TianBingzhuo/smart-car-embedded-vision-system/firmware/openart/README.zh-CN.txt

OpenART 部署说明：

把对应的脚本文件放到对应 SD 卡里，文件名改成 main.py 就会自动运行。down 对应下位板，up 对应上位板。
注意：目标检测的 SD 卡做了标记，识别的 SD 卡没做标记。两张卡里的模型不一样，不能混着放。

串口命令说明：
发 0：全部待机
发 1：上位 art 开启识别卡片
发 2：上位 art 开启识别字母
发 3：上位 art 开启识别数字 1、2、3
发 4：下位 art 开启目标检测

切换功能时先发 0，再发目标命令（1/2/3/4）。
