TianBingzhuo/smart-car-embedded-vision-system/firmware/rt1064/project/code/README.txt

如果你要加自己的代码文件，直接放到 CODE 文件夹下就行，不用再建子文件夹。然后在工程里添加文件就可以编译了。
