TianBingzhuo/smart-car-embedded-vision-system/hardware/pcb/PCB_钛合金狗眼_2026-05-22.png

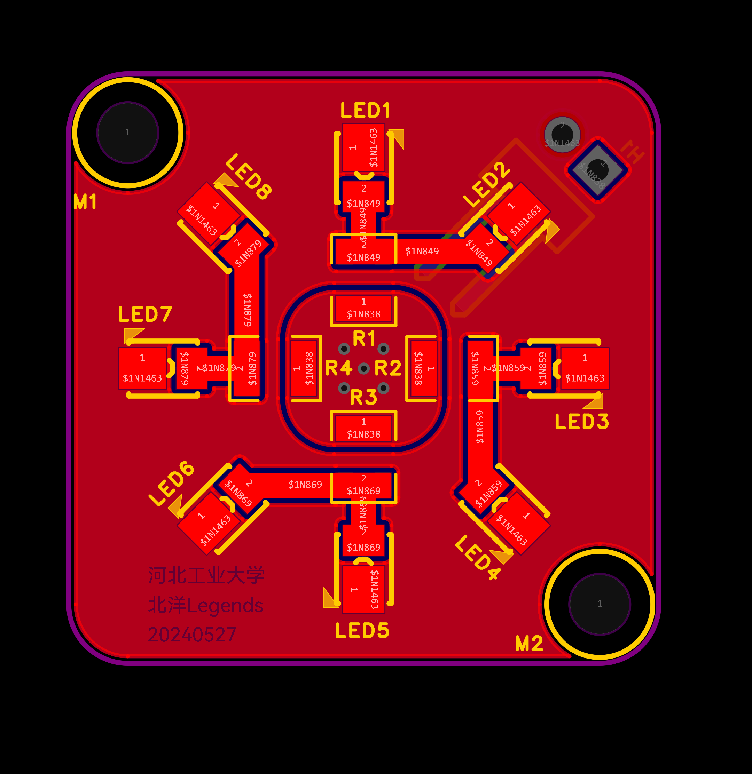
hardware/pcb/PCB_钛合金狗眼_2026-05-22.png
