TianBingzhuo/smart-car-embedded-vision-system/hardware/pcb/PCB_驱动板_2026-05-22.png

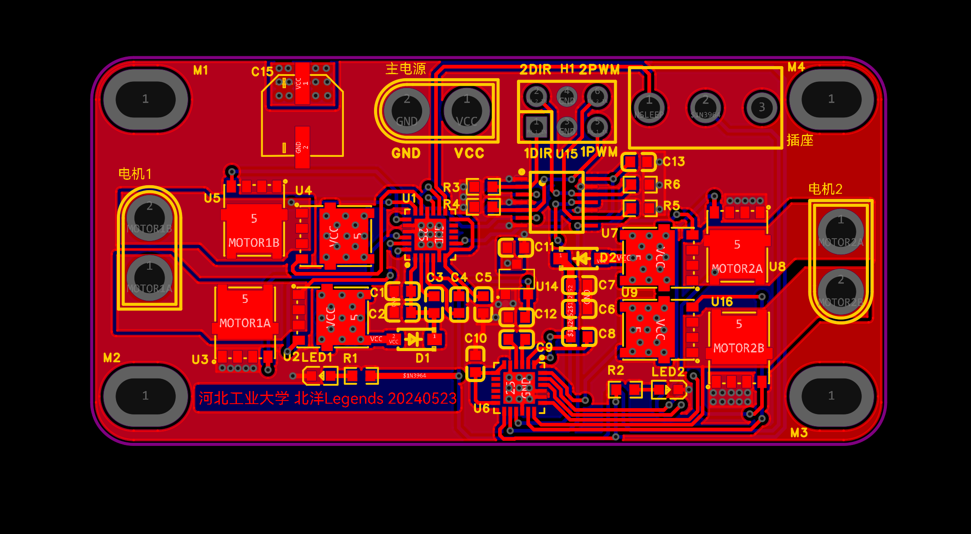
hardware/pcb/PCB_驱动板_2026-05-22.png
