TianBingzhuo/smart-car-embedded-vision-system/hardware/pcb/SCH_main-board-v2-P2_2026-05-22.png

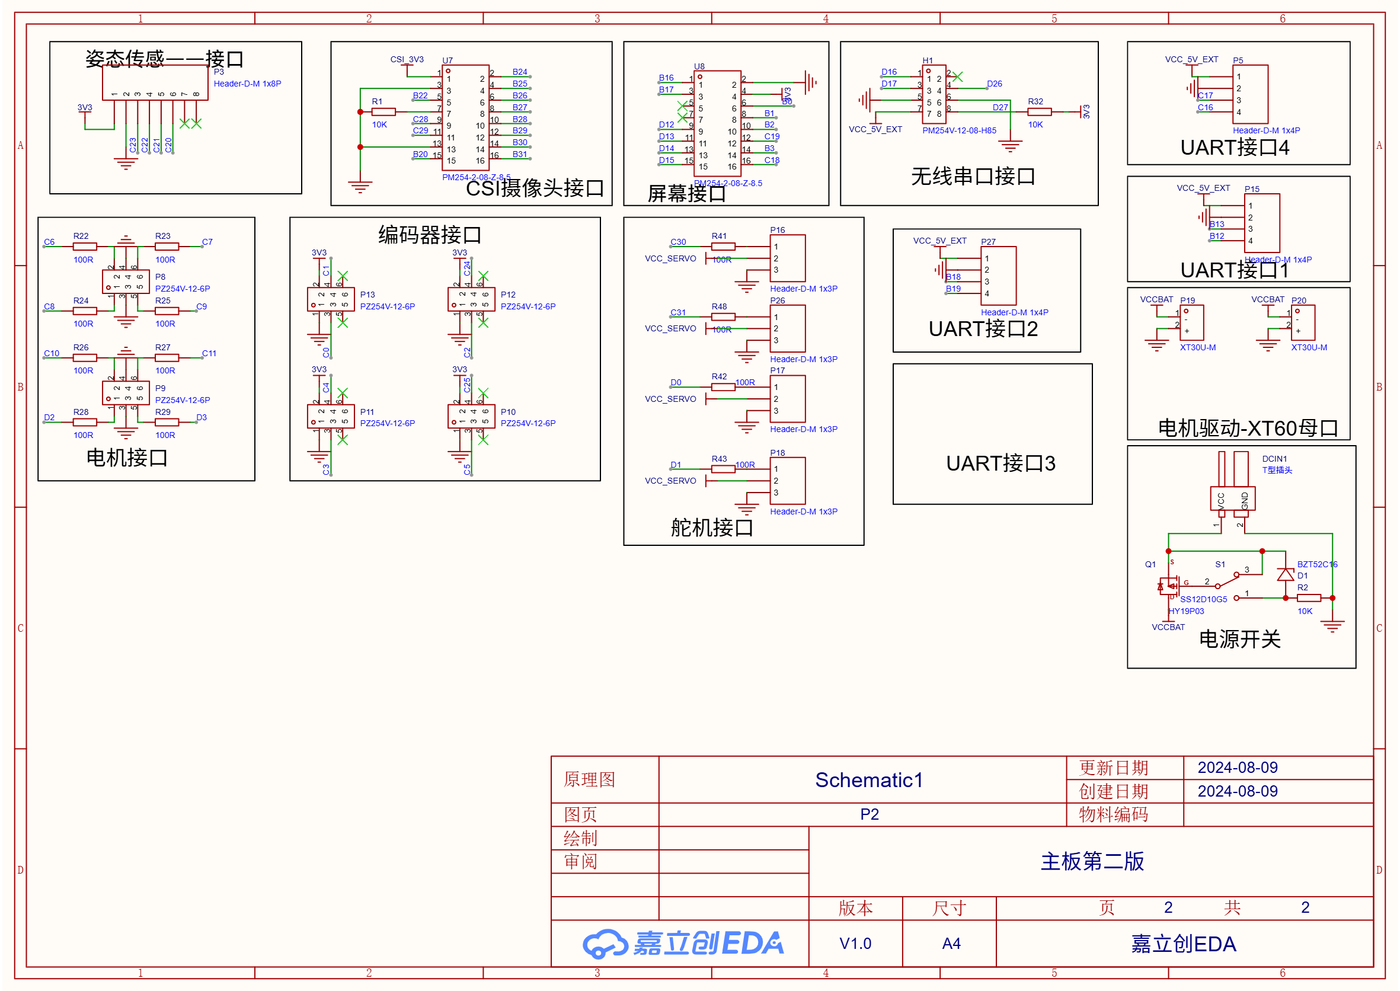
hardware/pcb/SCH_main-board-v2-P2_2026-05-22.png
