TianBingzhuo/smart-car-embedded-vision-system/hardware/pcb/SCH_titanium-dog-eye-P1_2026-05-22.png

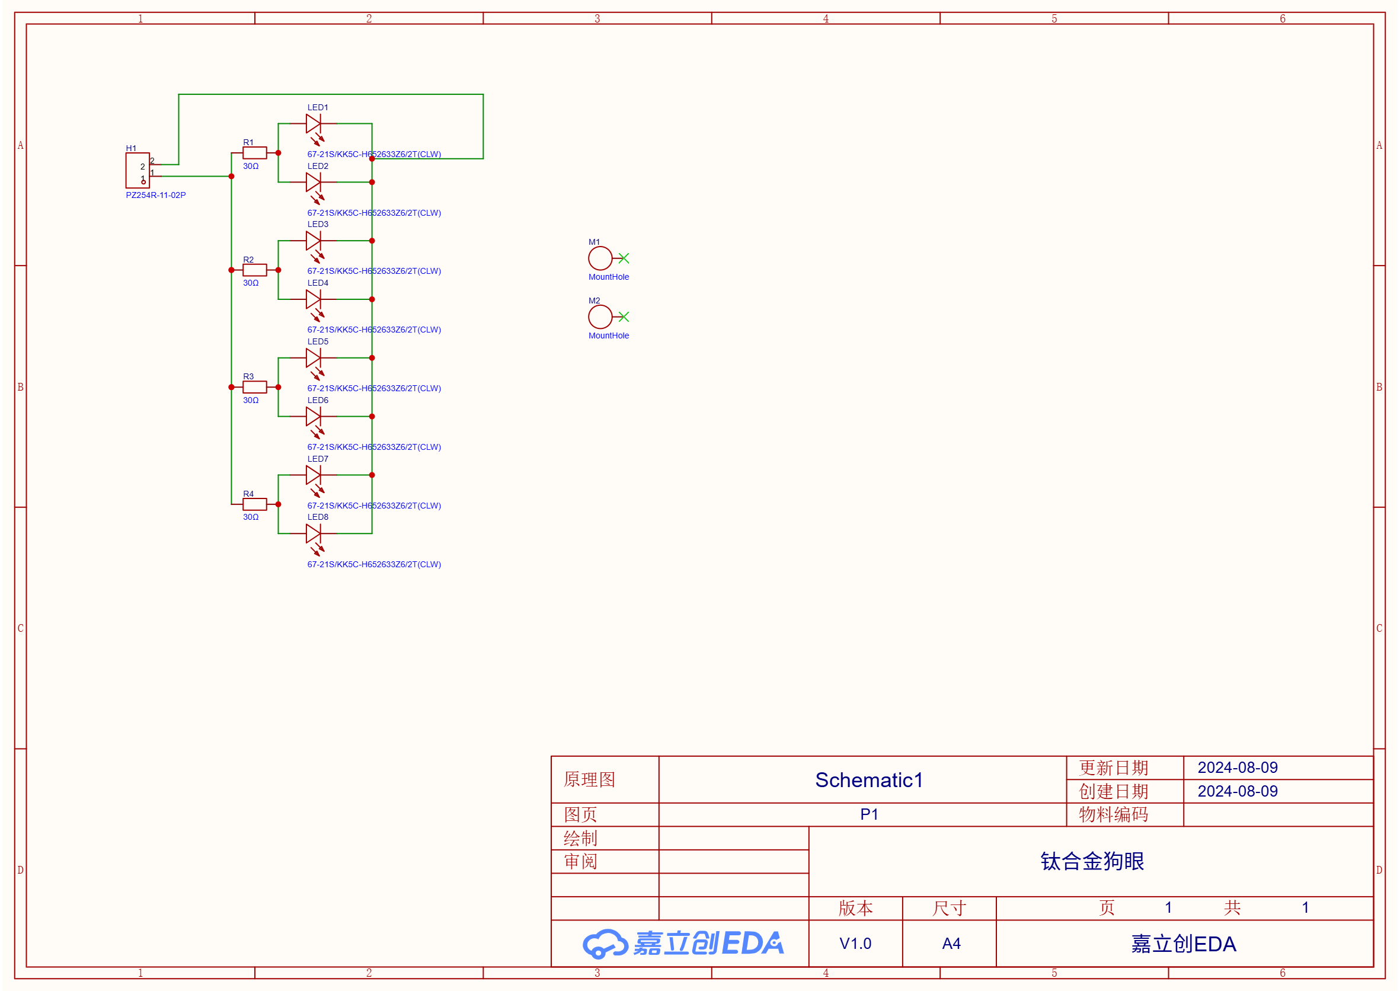
hardware/pcb/SCH_titanium-dog-eye-P1_2026-05-22.png
