TianBingzhuo/smart-car-embedded-vision-system/hardware/pcb/SCH_主板第一版-P1_2026-05-22.png

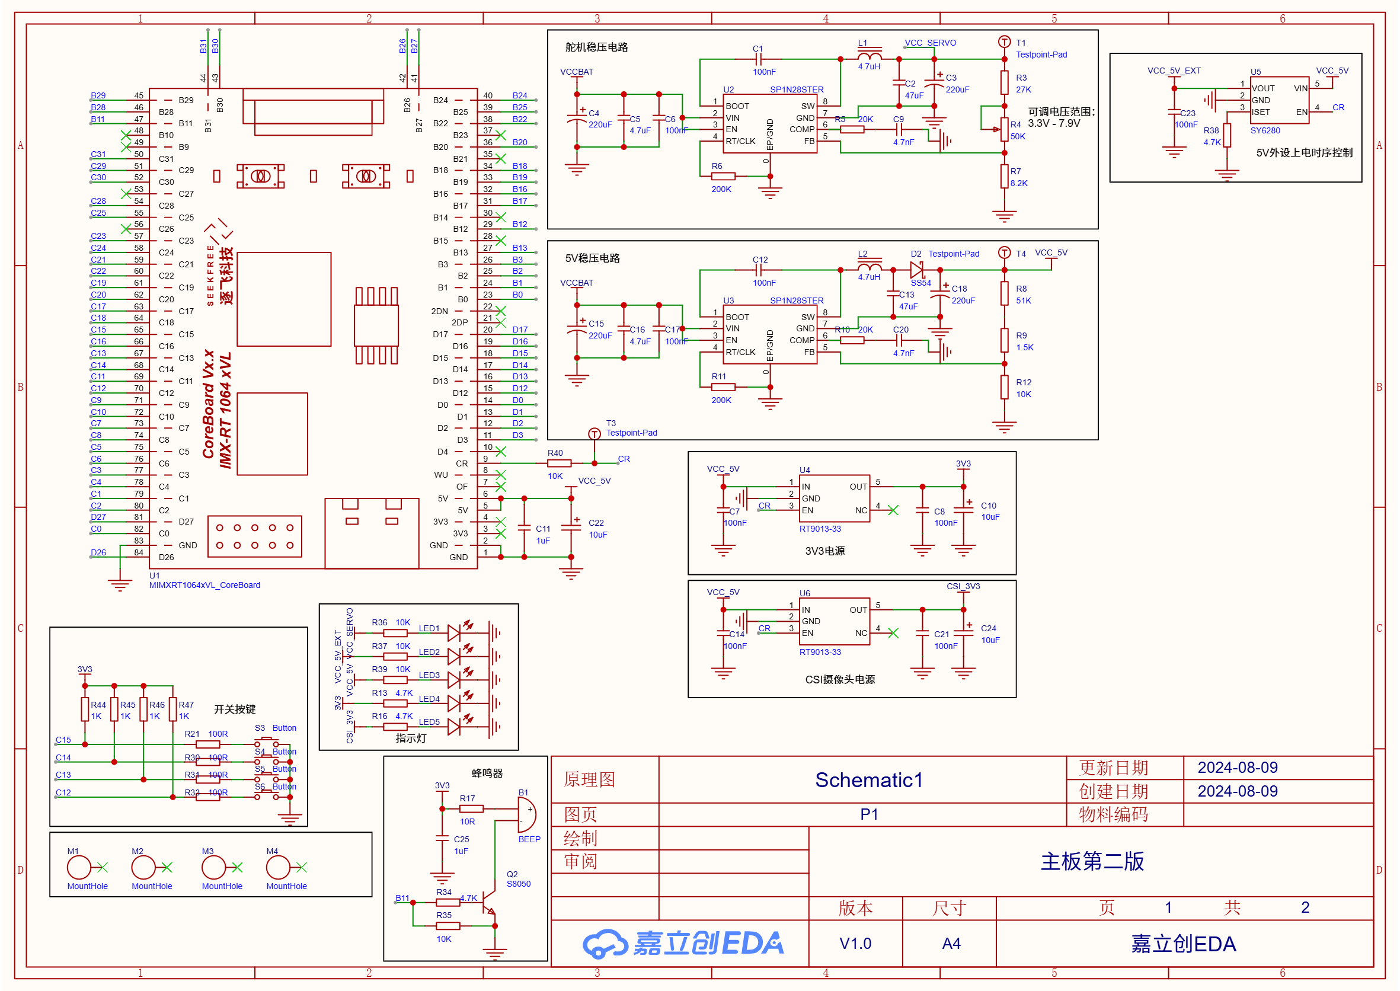
hardware/pcb/SCH_主板第一版-P1_2026-05-22.png
