TianBingzhuo/smart-car-embedded-vision-system/hardware/pcb/SCH_驱动板原理图_1-P1_2026-05-22.png

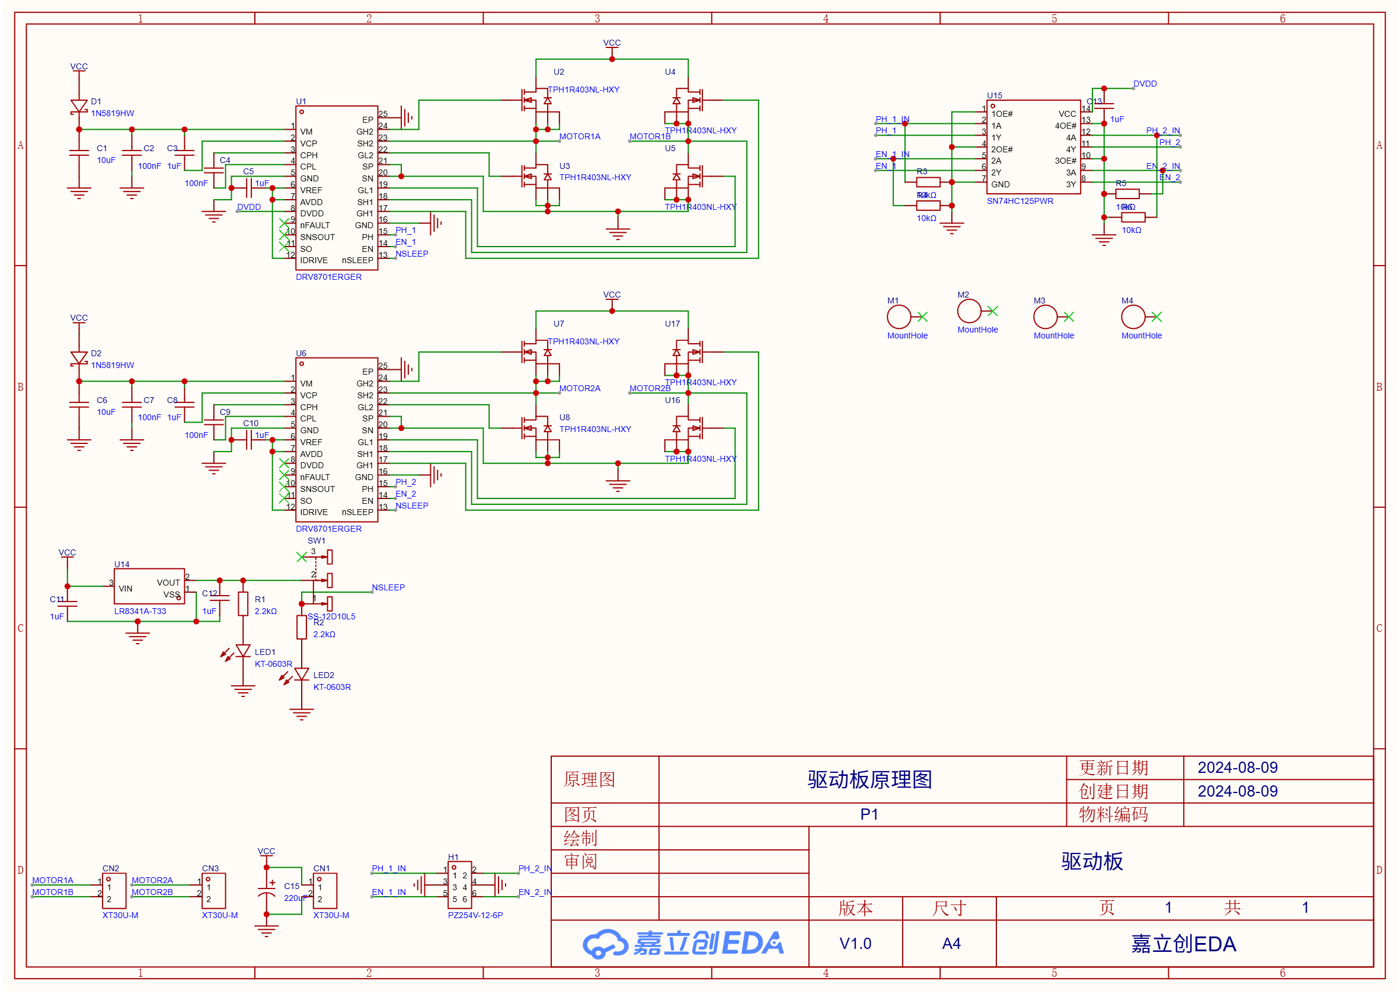
hardware/pcb/SCH_驱动板原理图_1-P1_2026-05-22.png
