TianBingzhuo/smart-car-embedded-vision-system/docs/raw-notes/bringup-log.zh-CN.txt

2-28 11：34
pid速度环还是调不通。大概率是板子的问题，代码是copy过来的不应该出现这种现象。
2-29 18:43
小车的各个运动模式初步写完了，pid也开始调了，后面还得精调。
2-29 23：52
在搞循迹。
初步想法是能不能把平移速度和旋转速度当成类似pid参数那样来调，像调pid一样去调平移和旋转之间的比例。
明天争取把循迹直接做出来。
现在的问题是：位置环怎么读？怎么转化成需要的速度？
这个搞定了就可以把转化出来的速度丢进速度转化公式，算出每个轮子需要的速度，最后直接pid速度闭环就行了。
3-2 16：10
循迹初步能跑了。
电机：调控参数得调小一点。
总钻风：圆环代码和避障代码还没写。
openart：数据对接还没弄。
小车：舵机还没装，得配合起来。
3-10 10：41
搞定了：wifi无线调参和控制车运动，循迹也调好了。

还没弄的：openart上车实测，车结构改装，硬件板子重做，舵机最后再说。
3.19
加了舵机代码、斑马线识别停车代码，循迹也改进了。
还没搞：openart上车、画板子、结构上车。
4.6
加了圆环循迹。除了openart和部分结构没上车，其他部件都装好能用了。
4.21
加了art逻辑代码、卡片检测代码、滤波代码，圆环循迹也完善了，主函数做了简化。
