TianBingzhuo/smart-car-embedded-vision-system/hardware/imu/imu-tuning-notes.zh-CN.txt

alpha：0.75f，Kp：12.8，Ki:0.001,halfT:0.658,dt:0.005;角度较为准确，扰动较少，静态无零漂。
alpha：0.75f，Kp：12.8，Ki:0.001,halfT:0.6564,dt:0.005;角度较为准确，扰动较少，静态无零漂，左右缓慢摇晃，误差较小，快速晃动，误差稍微增大大概±2°。
