TianBingzhuo/smart-car-embedded-vision-system/firmware/rt1064/project/code/steer.h

/*
 * steer.h
 *
 *  Created on: 2023年2月28日
 *      Author: lenovo
 */


#ifndef STEER_H_
#define STEER_H_

#include "motor.h"
#include "zf_common_headfile.h"


#define S3010_HZ 50         //中值40   左转96       右转70   中值  83
//extern int steer_middle;  //舵机中值
//extern int steer_left;    //左转
//extern int steer_right;   //右转
extern float steer_k_r;   //左右弯道补偿系数
extern float steer_k_l;
extern int err_v;
extern int outacc_flag;
#define steer_middle  633       //   633
#define steer_right   550            //舵机右打 560
#define steer_left    720             //舵机左打 710
#define LimitLeft(Left)    (Left = ((Left > steer_left) ? steer_left : Left))  //占空比越大，越往左打角。占空比越小越往右打角。
#define LimitRight(Right)  (Right = ((Right < steer_right) ? steer_right : Right))
extern int S3010_Duty;
//#define SD_HZ    50                    //中值40   左转96       右转70   中值
//83 #define steer_middle   66//75//69 #define steer_left  79//80//89 //84
////车向左转（舵机右打） #define steer_right 51//52//61           //54
////车向右转（舵机左打）
#define SD_Intertal_L 82  //车向左转（舵机右打）
#define SD_Intertal_R 84  //车向右转（舵机左打）
//
//
//#define LimitLeft(Left)     (Left=((Left>steer_left)? steer_left:Left))
//#define LimitRight(Right)   (Right=((Right< steer_right) ? steer_right :
//Right))

//typedef struct {
//  PID_Datatypedef Straight;
//  PID_Datatypedef Bend_Large;
//  PID_Datatypedef Bend_Small;
//} Piord_PD;
//extern Piord_PD Po_PID;
//extern PID_Datatypedef SteerPIDdata;
extern float Steer_pl;
extern float Steer_ph;
extern float Steer_d;
extern int sterr;
void Steer_init(void);
void SteerControl(uint32 duty);
void SteerPID_Realize(float offset);
void SteerPID_Realize_4(int offset);
void SteerPID_Realize_5(int offset);
void SteerPID_Realize_6(int offset);
void SteerPID_Realize_7(int offset);
void SteerPID_Realize_8(int offset);



#endif /* STEER_H_ */
