TianBingzhuo/smart-car-embedded-vision-system/firmware/rt1064/project/code/steer.c

/*
 * steer.c — Steering control module (snapshot note)
 *
 * The steering implementation (functions declared in steer.h) was developed
 * in a separate compilation unit that is not part of this public snapshot.
 * This file is kept as a structural placeholder to show the module boundary
 * in the original embedded project layout.
 */

#include "camera.h"
#include "motor.h"
#include "steer.h"
