TianBingzhuo/smart-car-embedded-vision-system/firmware/rt1064/project/code/location.h

//
// Created by ThinkPad on 2022/6/28.
//

#ifndef _LOCATION_H
#define _LOCATION_H

#include <stdbool.h>
#include <math.h>
#include <stdlib.h>
#include "zf_common_headfile.h"

#define locate_sz 12             //坐标数组数量，目标点数不确定！(5-20都有可能)

//---------------------结构体---------------------//
//记录坐标和相对位置的结构体
typedef struct location_goal {
    //已到达的目标点
    int8_t Position_Pointer;
    //当前速度
    double Speed_X;
    double Speed_Y;
    double Speed_Z;
    //当前位置
    float x;
    float y;
    //目标位置
    float x1;
    float y1;
    //当前姿态
    float Angel;
    //目标姿态
    double Angel_Target;
    //目标距离
    float DistanceX;
    float DistanceY;
    //距上次转向之后前进的距离(里程）
    float MileageX;
    float MileageY;
}location_goal;

extern location_goal Car;
extern uint8 Xt , Xb , Yl , Yr ;
extern int originMap[locate_sz][2];


//void carlocation_init(void);

//void location_thres_init(void);
//void get_route();
//void initHashMap(int true_sz);



#endif
