TianBingzhuo/smart-car-embedded-vision-system/firmware/rt1064/project/code/wirles_usart.h

#ifndef _WIRLES_USART_H_
#define _WIRLES_USART_H_

#include "zf_common_headfile.h"

void wirles_usart_init(void);
void show_oscilloscope_wirlesusart(void);

extern seekfree_assistant_oscilloscope_struct oscilloscope_data;

#endif 
