TianBingzhuo/smart-car-embedded-vision-system/(commit log)

2026-05-22 Initial public project release
    [cmm_cfg.csv, imu660ra_config_array.txt]
2026-10-21 docs: credit Astra A1 and record bounded October PCB review
